robertbedichek/solartracker/hydraulic_motor_pump_in_garage.jpeg

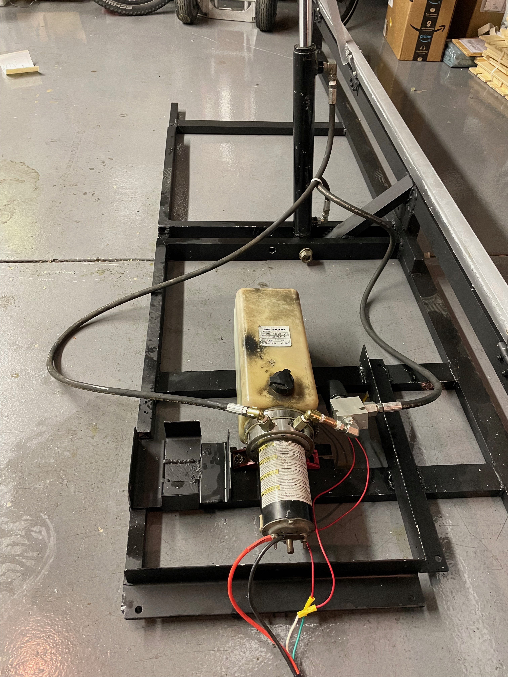
hydraulic_motor_pump_in_garage.jpeg
