robertbedichek/solartracker/solar_tracker_controller_on_bench_nov15_2021.jpg

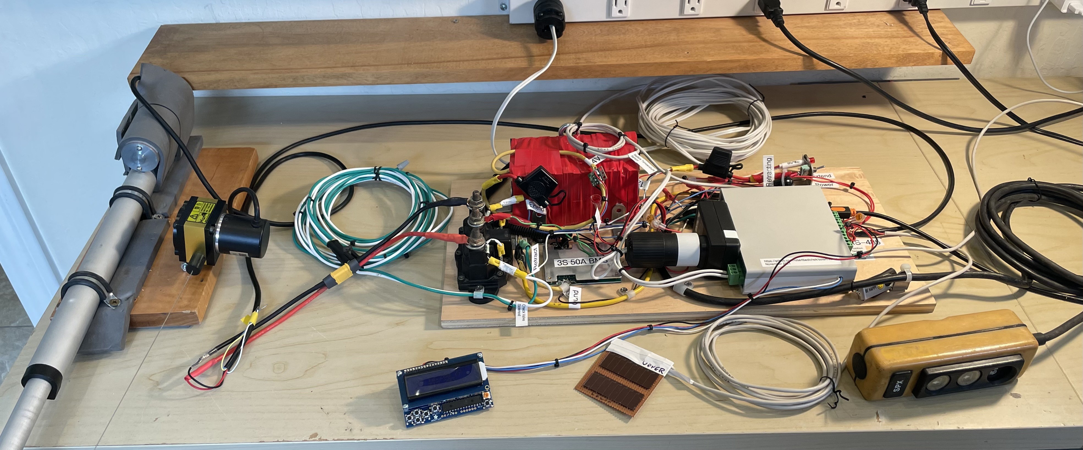
solar_tracker_controller_on_bench_nov15_2021.jpg
