robertbedichek/solartracker/README.md

# solartracker
Documents relating to and supporting the development of a device to track the sun and control hydraulics
