robertbedichek/solartracker/BMS_image1.png

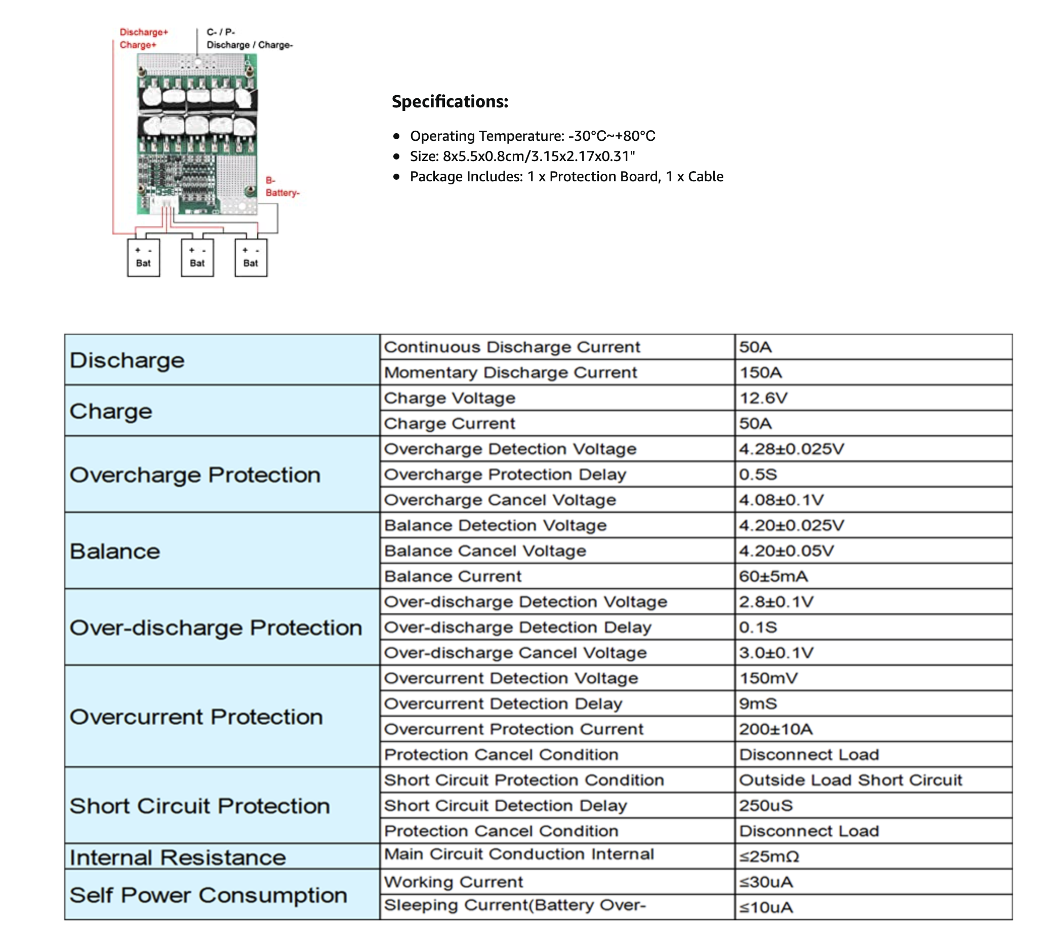
BMS_image1.png
