robertbedichek/solartracker/BMS_image2.png

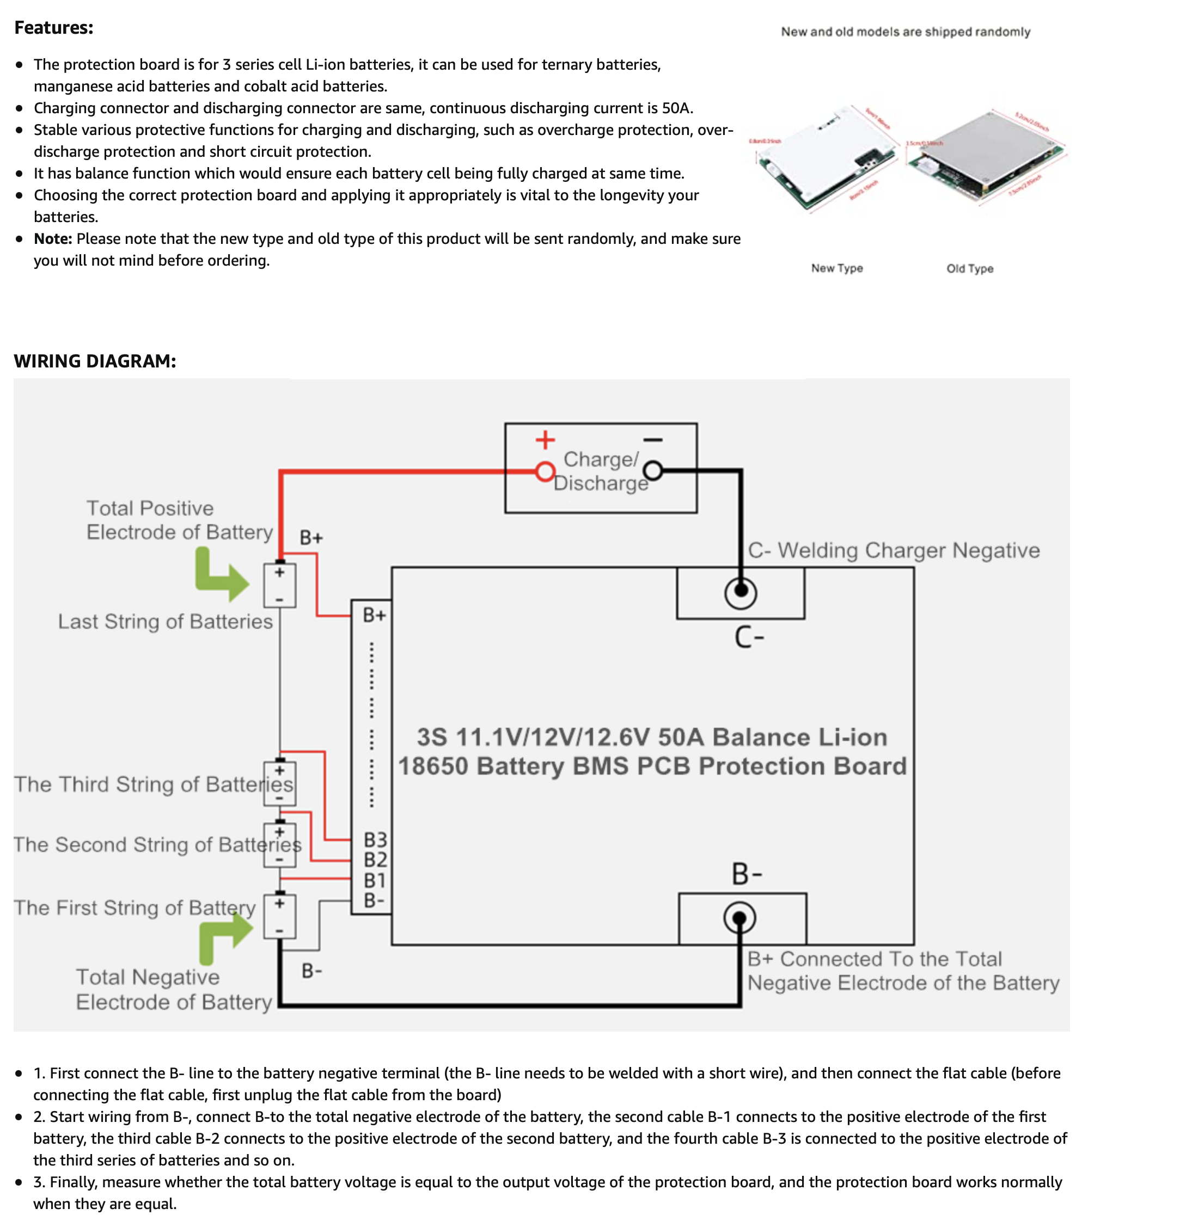
BMS_image2.png
