robertbedichek/solartracker/draw_wire_sensor_1.png

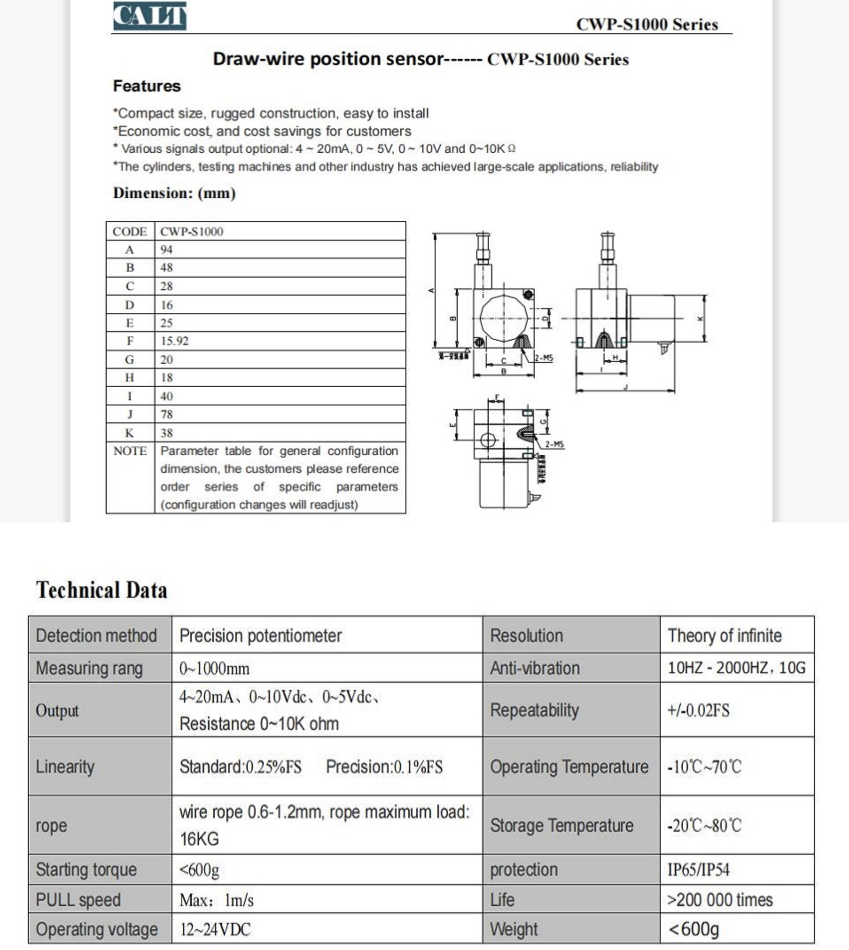
draw_wire_sensor_1.png
