robertbedichek/solartracker/draw_wire_sensor_2.png

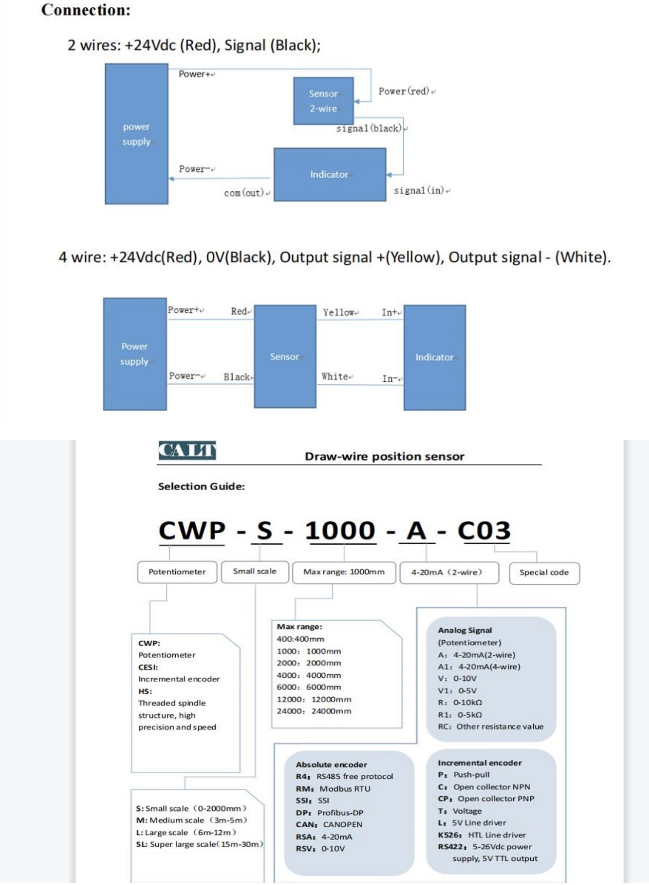
draw_wire_sensor_2.png
