robertbedichek/solartracker/solar_tracker_controller_on_bench_close_up_nov15_2021.jpg

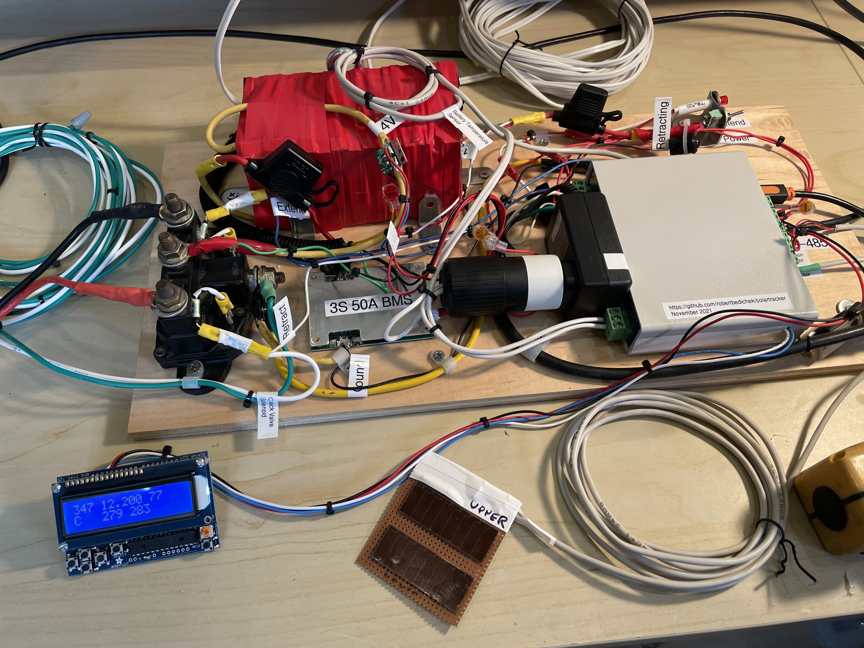
solar_tracker_controller_on_bench_close_up_nov15_2021.jpg
