robertbedichek/solartracker/contactor_wiring_diagram.pdf

11-3513

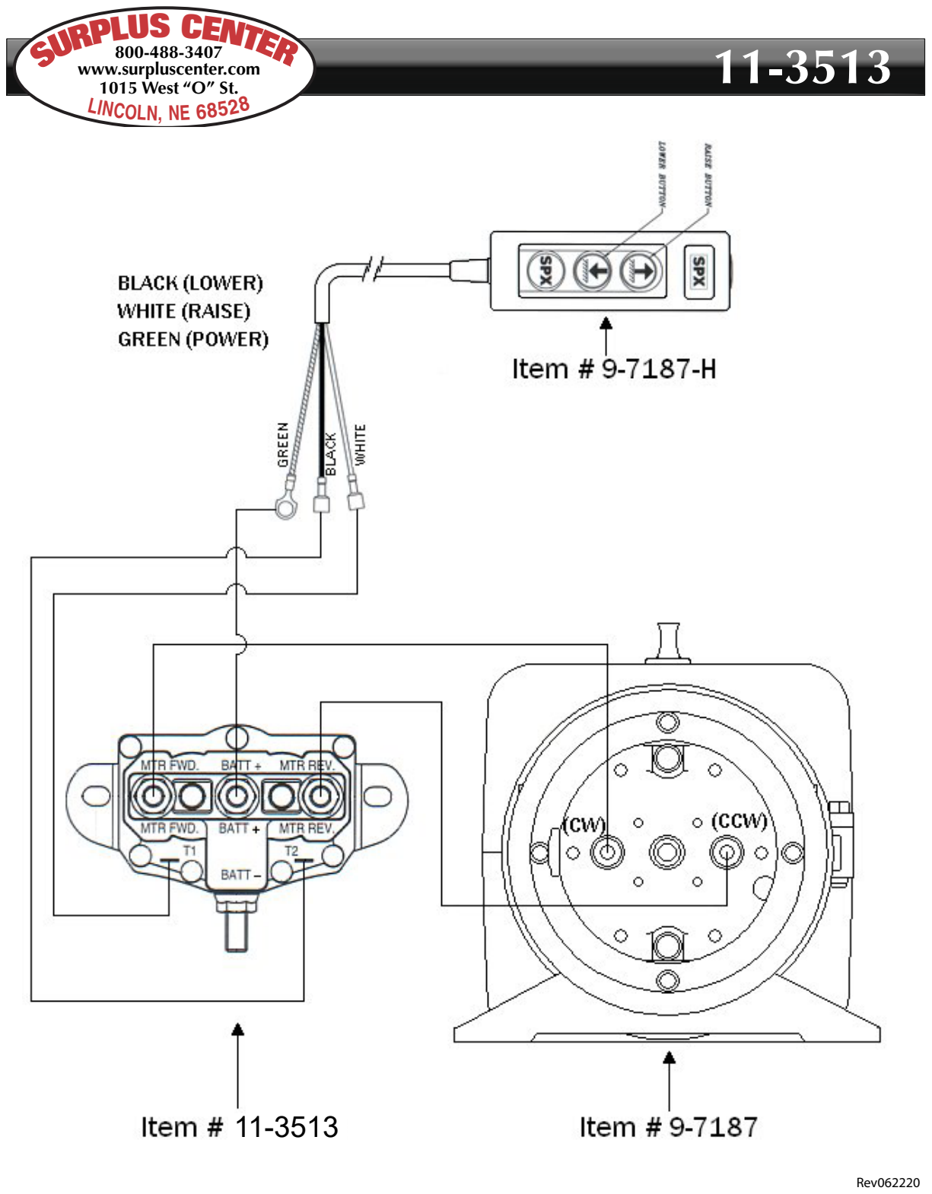
[picture p8: page 1]

800-488-3407
www.surpluscenter.com
1015 West “O” St.

# SURPLUS CENTER

### LINCOLN, NE 68528

Rev062220

11-3513
