robertbedichek/solartracker/pendant_specs.pdf

800-488-3407

## www.surpluscenter.com

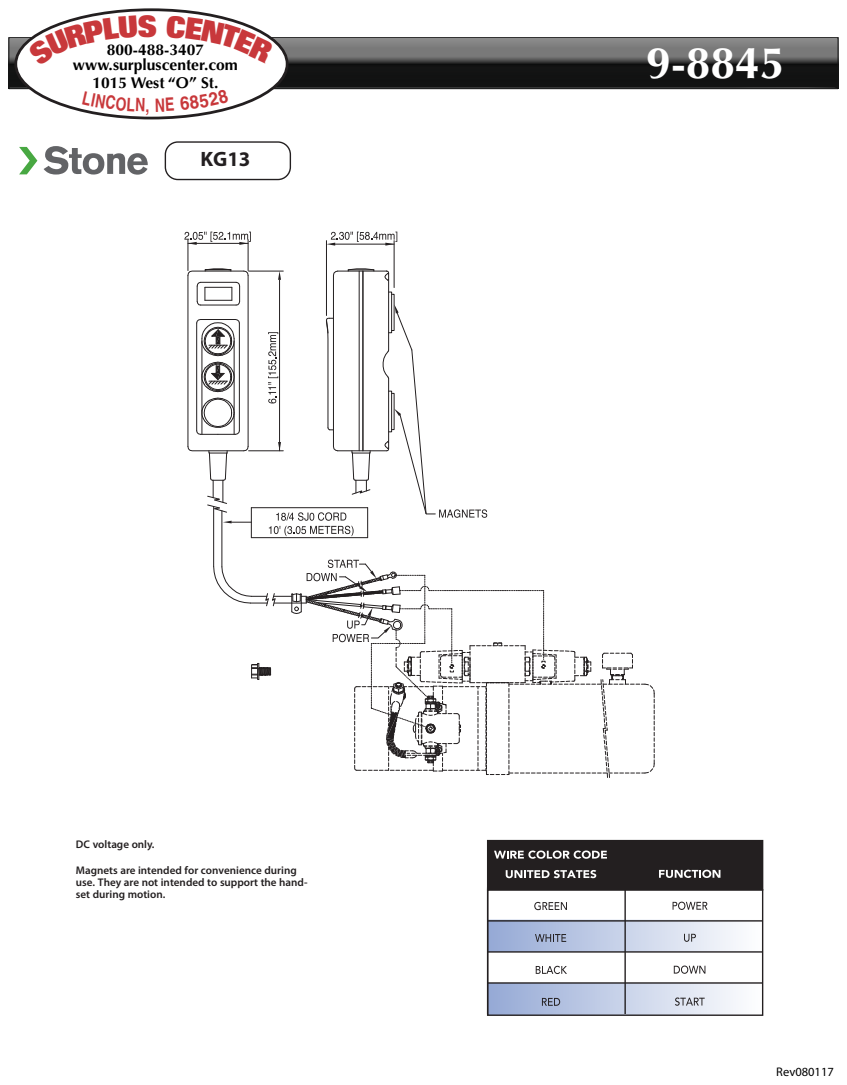
[picture p9: page 1]
1015 West “O” St.; SURPLUS CENTER; LINCOLN, NE 68528; Rev080117

DC voltage only.
Magnets are intended for convenience during
use. They are not intended to support the hand-
set during motion.
