robertbedichek/solartracker/solartracker_pcb.pdf

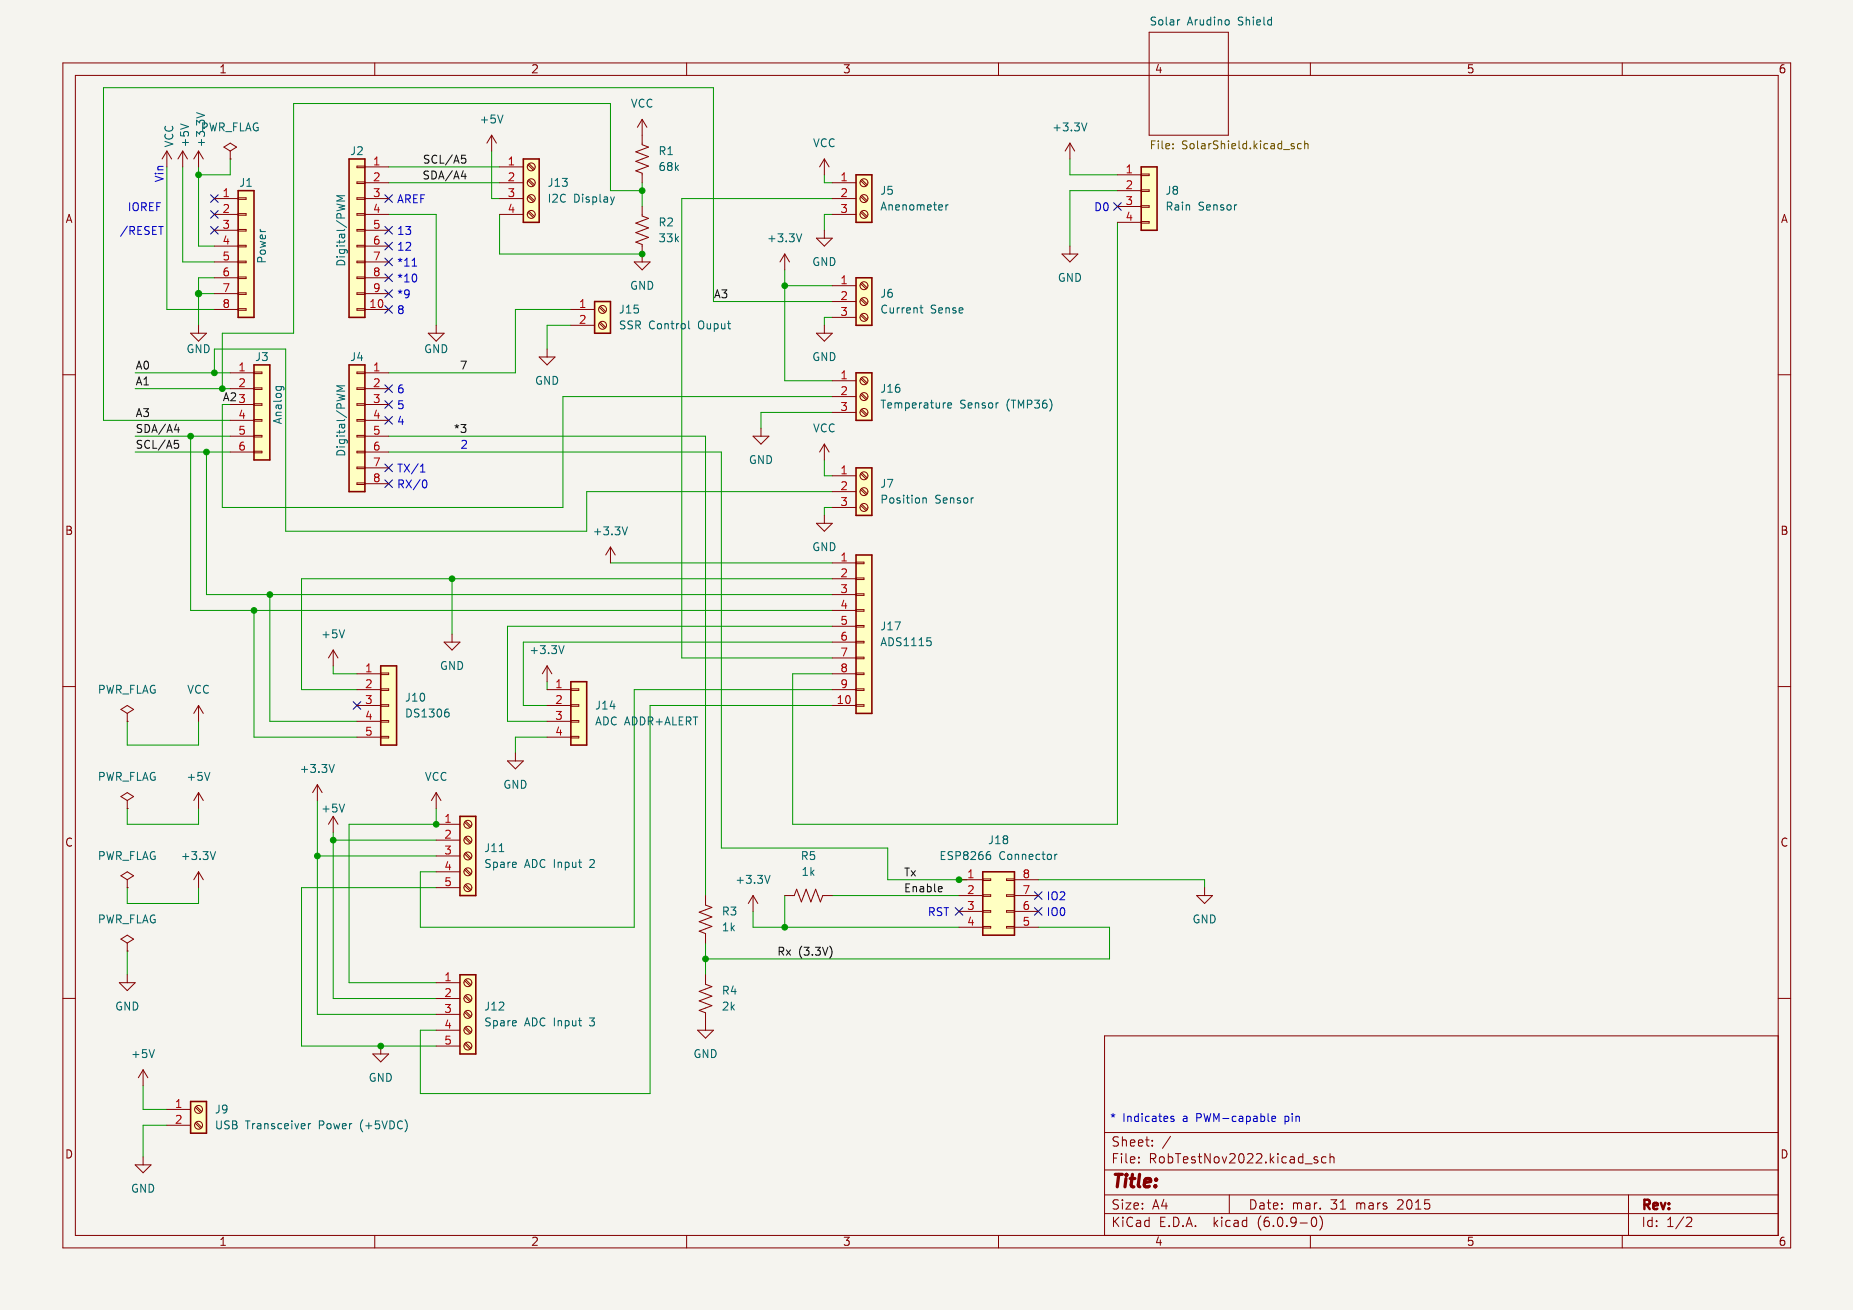
[picture p11: page 1]

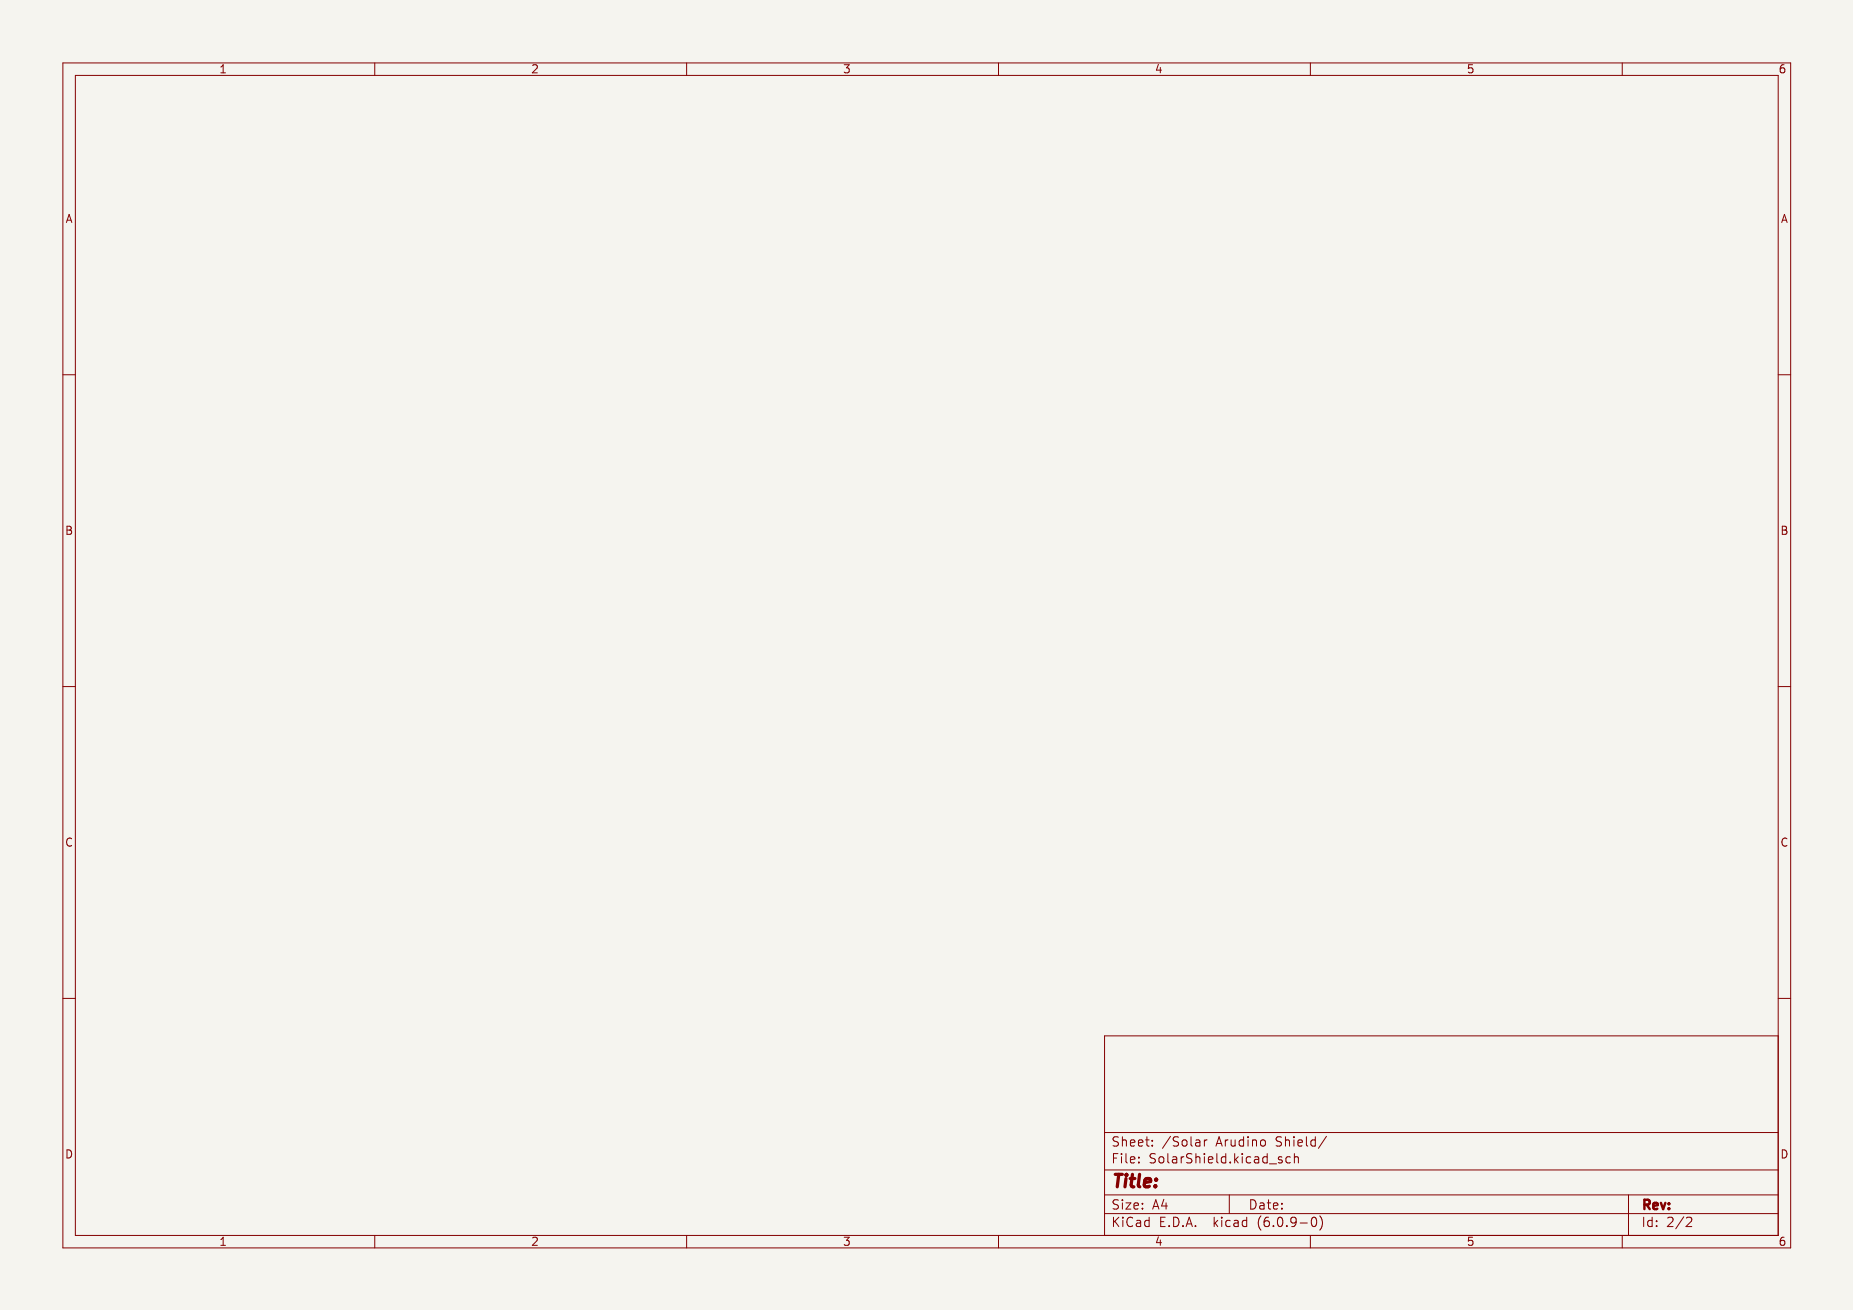
[picture p12: page 2]
