robertbedichek/solartracker/(commit log)

2021-11-11 Initial commit with some of the design collateral
    The code works on the bench. Still to-do are to fix the RS-485 code to allow remote adjustment of calibration values, to save and fetch calibration values to EEPROM, and to support a future local interface (a few keys and a 2-line LCD display so that one can adjust and examine without needing a computer with a RS-485 interface). On the bench, I have a linear actuator in place of the hydraulic motor, so the default calibration values in this commit are certain to be way off.
2021-11-11 First version of the C source code, an Arduino sketch
2021-11-15 Added LCD and RTC code, draw wire sensor docs
    LCD and RTC code works. Unfortunately, serial input over RS-485 not working.
2021-11-15 Two pictures added of controller on bench
    The linear actuator is a stand-in for the hydraulic motor (which is big and connected to hydraulic lines, lives outside). Everything else in the photo will be part of the working system (inside an enclosure).
2021-12-01 Added spec sheet for the current/voltage sensor on the 4V line
2021-12-03 Added picture of hydraulic pump/motor installed, in garage
2022-06-01 Add files via upload
    Fixed windspeed code, updated crontab. Now copy RTC date/time to Arduino time every day. Controller is on roof now, goes up in time mode. Does not go down in time mode for some reason. Switching to Mac mini as dev machine as it is now connected via USB to controller.
2022-07-27 Add files via upload
    Change the gain to be 2/3rds, to allow sun angle sensor range to be measured.
2022-11-05 added rain-stow and wind-stow modes. Added monitoring of 4V stage of Li pack. Deprecated solar-sensor mode (now in #ifdefs). Added position mode. Added monitor for motor stall.
2022-12-21 removed rs485 and kt233 remnants. added control of SSR for 8V PS. removed battery management. removed sun angle sensor code. added single brightness sensor code
2023-12-29 extensive changes, added RS-232 code, removed time_mode, separated current limit into two, one for up and one for moving down
2025-04-06 Switched from counting number of stalls and number of undercurrent readings to a more robust method based on setting the start time for stalls and start time for undercurrent readings.
    On stalls, we now reset the limits, to adapt.
    On current, we now stop trying to move the panels if there is an undercurrent
    reading.
    Changed a lot of #defines to "const ..".
    Now keep the power supply on for a while instead of turning it on and
    off for each panel movement.
    Updated telemetry output to match date/time format of plotyJS and made
    it less frequent.
    More diagnostics.
    [solartracker.ino]
2025-04-11 1. Added flag to indicate whether the last thing we did with the panels was to put them all the way down and if so, not try to retract them. 2. Added diagnostic messages for who is calling for the pa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
2025-04-21 1. Increase low-wind threshold from 1 to 2 knots 2. Fix character buffer to be large enough for time/current/voltage messages 3. Fix wind-stow timer limit (was far too high) 4. Fix logic bug with ret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
    [solartracker.ino]
2025-04-27 1. Removed several Println() with alert messages 2. Fixed numeric overflow in time expression 3. Tuned the response to overcurrent 4. Fix bug where the global "rain_volts" was not being set
    [solartracker.ino]
2025-04-27 Fixed more integer overflow issues in rain-stow logic.
    [solartracker.ino]
2025-05-09 remove old C based host program for receiving serial data; add PDF of schematic
2025-05-09 remove docs for an Arduino I no longer use
2025-05-10 1. Removed monitor_motor_on_time task. It is redundant with the tasks that monitor for stalls. 2. Added code to control the new solenoid power supply SSR to match the new SSR, the power supply it ena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
    [solartracker.ino]
2025-05-29 fix bugs with letting panels fall without powering them down
    [gobble_solartracker.py, watch_serial_and_run_gobble_solartracker.py]
2025-06-01 Replace hard coded user directory with $HOME
    [gobble_solartracker.py]
2025-06-01 Made the let-panels-fall-slowly option cycle the solenoid on and off. With this, they are getting down the low position by early morning.
2025-06-05 fix fatal bug recently introduced
    [gobble_solartracker.py]
2025-06-05 make it less verbose, all those informational messages were confusing the JS ploty package (it seems). In any case, no need for some much verbosity anymore
2025-06-13 add date and time commands to serial console. Increased current limit on lifting to 100A (from 95). mDisable wind stow mode by default
2025-06-13 fix the logic that disabled wind stow mode
    [solartracker.ino]
2025-11-15 1. Fixed path of data file on web server of data file that receives the telemetry from the solar tracker 2. Removed the global 'arduino_time'. Now code that needs the time calls now(). 3. Fixed numer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
    [gobble_solartracker.py, solartracker.ino]
2025-11-15 make fixes for issues Claude pointed out: removed unused globals, fixed the calculation of milliseconds since last panel-raise, eliminated hokey DST correction code, fixed inverted test of return val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
    [solartracker.ino]
2025-11-15 fixed syntax errors accidentally checked in a few minutes ago; removed more dead variables and code
    [solartracker.ino]
2025-11-15 more fixes from Claude: time overflow, unused macro and constants, incorrect setting of yyear value when writing the RTC, typo in comment
    [solartracker.ino]
2025-11-16 Ensure solenoid and motor power supply are off at boot; remove redundant function for monitoring upward panel movement; add solenoid-is-on status to telemetry; re-enable wind-stow mode; slight refact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
2025-12-09 disable wind-stow mode (sensor acting up again); add rain-stow and wind-stow indications to the telemetry
2026-02-22 changed to match direct connection of 100A PS to hydraulic motor; rearrangement of init code to try to find hardware issue
    [solartracker.ino]
2026-02-28 1. Removed support for all the I2C devices (quad relay, RTC, A/D, display, keys) to match new simplified hardware design 2. Removed support for driving panels down actively, now we only turn on the b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
2026-04-16 1. updated entitlement file to use unique log file names 2. updated gobble script to use new port name and reduced number of fields 3. removed rain-stow logic. removed powered go-down logic (panels n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
2026-04-19 1. Added file that is a backup of index.html file that turms the telemetry that the Arduinos send to the server into graphs 2. Added more sophisticate filtering of position readings, though this didn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
    [solartracker.ino]
2026-04-21 1. Many small tweaks to operational logic, initialization, telemetry output. a. In particular, fixed a bug where we weren't properly determining whether the solenoid is on.
    [gobble_solartracker.py, solartracker.ino]
2026-04-24 Rename print_status_to_serial task/callback to emit_telemetry; substitute last known position for out-of-range sensor samples
    Bad position samples (>= 380) are now replaced with the last valid reading before sorting and averaging, preventing corrupt values from skewing the filtered position. Also fixes a bug where the warning counter was not always incremented due to short-circuit evaluation.
    [solartracker.ino]
2026-04-24 Raise PV current threshold for panel raise from 0.1A to 1.0A
    The Hall Effect sensor's absolute-value output means noise alone can exceed
    0.1A at night, causing panels to raise when the clock is wrong (e.g. after
    a reboot with no gobble script running to set the time). 1.0A is safely
    above sensor noise but easily met with any real solar production.
    [solartracker.ino]
2026-04-24 Fix three bugs and clean up minor issues in emit_telemetry_callback and elsewhere
    Bugs fixed:
    - last_motor_is_on was never updated, causing telemetry to fire every call while motor was on
    - motor_amps() was called three times per telemetry call; now read once into cur_motor_amps
    - pv_current() was called twice (last_pv_current stored but ignored); output now uses last_pv_current
    Minor fixes:
    - Remove unused #include <SoftwareSerial.h>
    - Remove dead operation_mode_string() declaration and definition
    - Remove unused minutes_of_hour variable in drive_panels_to_desired_position()
    - Remove dead EMA alpha/first_time code (alpha was always 1.0, making the filter a no-op)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
    [solartracker.ino]
2026-04-24 Fix desired_position formula for time-proportional panel raising
    Changed addend from position_upper_limit to position_lower_limit, giving
    correct intermediate targets (e.g. 122 at 8AM, 330 at noon) instead of
    always exceeding the upper limit and driving straight to the top.
    [solartracker.ino]
2026-04-24 Replace time-based panel scheduling with PV-current-based control
    Raise logic: drive panels up whenever pv > 1.0A, no stall limit exceeded,
    and 30 minutes have elapsed since last raise. No time-of-day window.
    Lower logic: drive panels down after pv has been below 0.2A for 45
    consecutive minutes. A cloud clearing resets the timer, preventing
    spurious lowering during passing clouds.
    Daily stall count resets at dawn (pv rises above 0.2A while panels are
    at lower position) instead of at midnight.
    Each raise is now capped at 5 seconds by monitor_position_limits_callback,
    providing an additional safety bound per raise event.
    Removes: desired_position, time_of_day_valid, panel_movement_start_ho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
    [solartracker.ino]
2026-08-20 1. Added ability for pendant control to ask for panels to lower. Turn on the solenoid, let panels fall. 2. Improved filtering of motor current sampling 3. Track lowest value of solar current (e.g., d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
2026-09-28 widen the range of values that the position sensor can return
2026-10-14 Watch the tracker's own port (1440), matching gobble_solartracker.py
    The watcher waited for 11440, the solar thermal controller's port, so the
    tracker logger only ran while that device happened to be present.
